mergedk/tokyo/tokyo.brd

## EAGLE design tokyo.brd (2019-07-08)

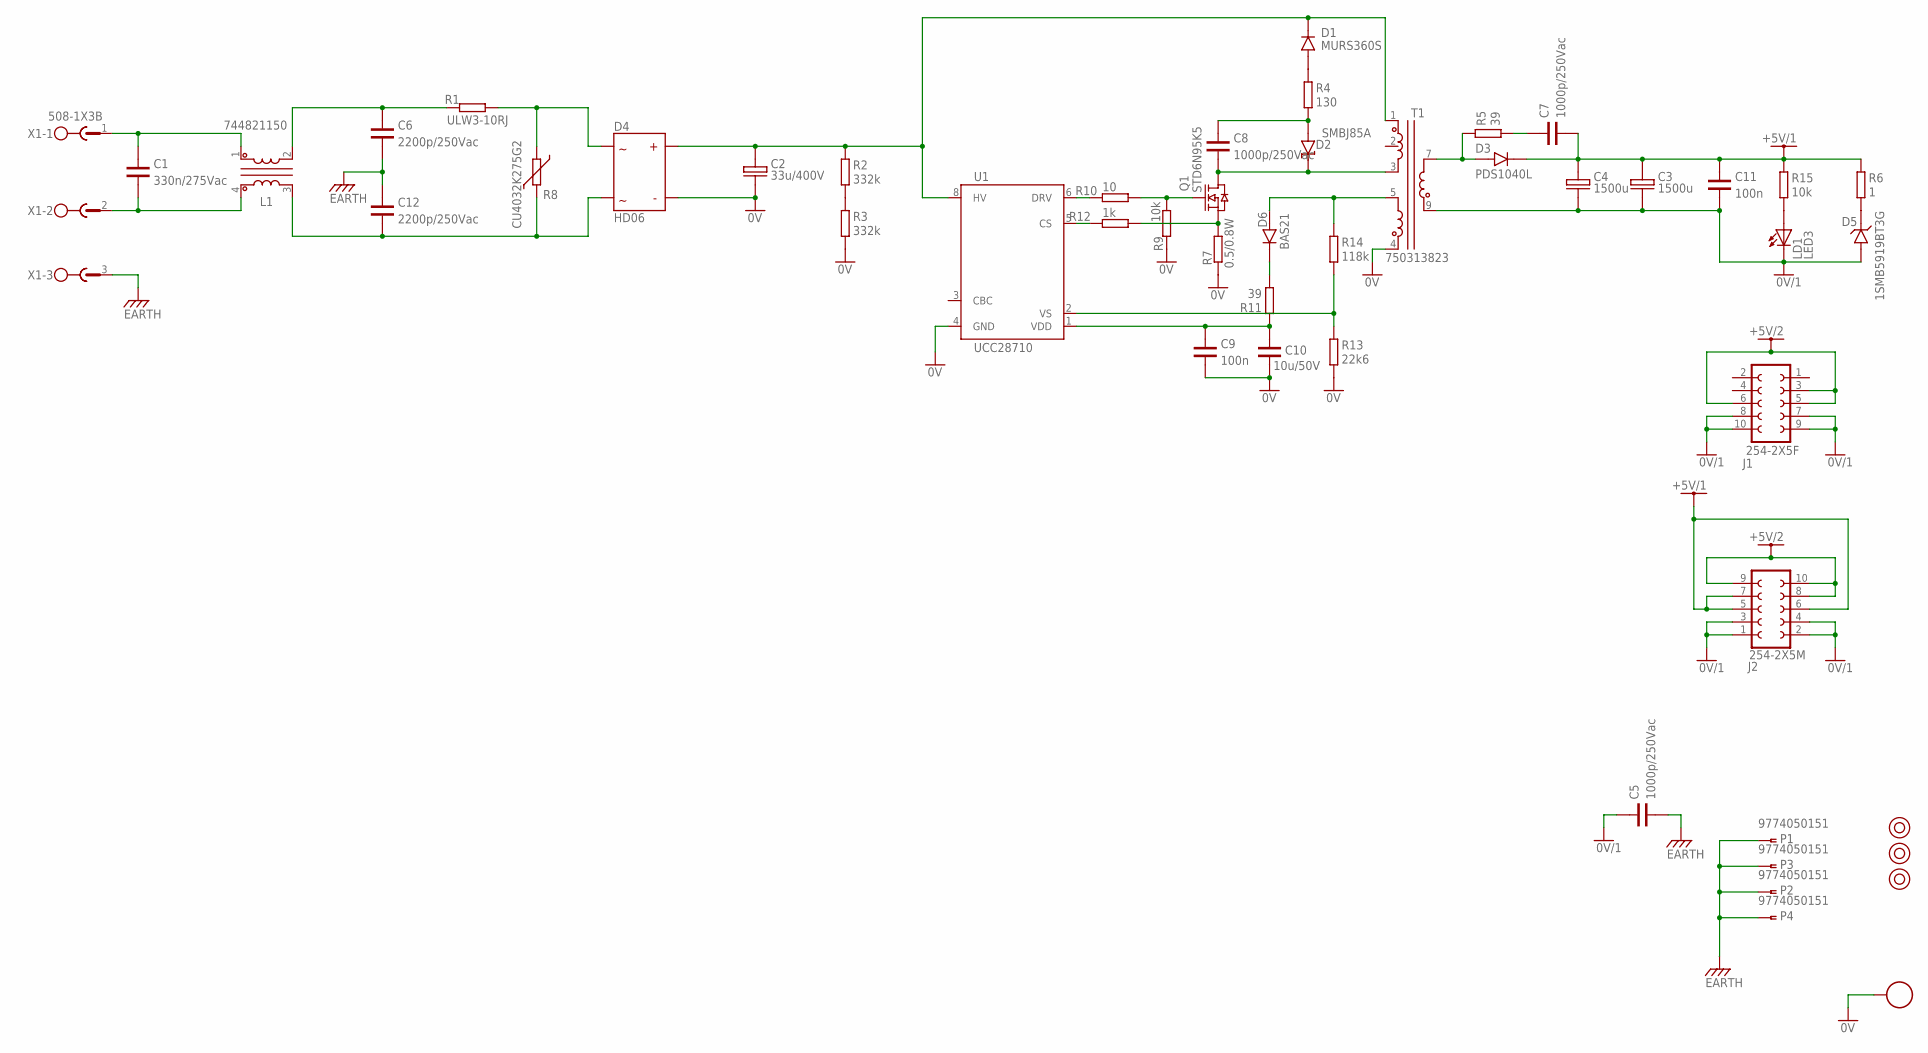
[picture p1: schematic tokyo.sch]

Parts:
0V: TESTPOINT
C1: 330n/275Vac; 15X8.5
C2: 33u/400V; D18
C3, C4: 1500u; D10
C5, C7, C8: 1000p/250Vac; 1812
C6, C12: 2200p/250Vac; 2211
C9, C11: 100n; 0603
C10: 10u/50V; 1206
D1: MURS360S; DO-214AA
D2: SMBJ85A; DO-214AA
D3: PDS1040L; POWERDI5
D4: HD06; MINIDIP
D5: 1SMB5919BT3G; DO-214AA
D6: BAS21; SOT23
FIDUCIAL1, FIDUCIAL2, FIDUCIAL3: FIDUCIAL
J1: 254-2X5F
J2: 254-2X5M
L1: 744821150
LD1: LED3
P1, P2, P3, P4: 9774050151
Q1: STD6N95K5; DPAK
R1: ULW3-10RJ; 15X6
R2, R3: 332k; 1206
R4: 130; 1206
R5: 39; 1206
R6: 1; 1206
R7: 0.5/0.8W; 2512
R8: CU4032K275G2; 4032
R9, R15: 10k; 0603
R10: 10; 0603
R11: 39; 0603
R12: 1k; 0603
R13: 22k6; 0603
R14: 118k; 0603
T1: 750313823; EE16
U1: UCC28710; SOIC7
X1: 508-1X3B

Connections:
0V: 0V.P$1, C2.2, C9.2, C10.2, D4.2, R3.2, R7.1, R9.1, R13.2, T1.4, U1.4 (GND)
0V/1: C3.2, C4.2, C5.1, C11.2, D5.2, J1.7, J1.8, J1.9, J1.10, J2.1, J2.2, J2.3, J2.4, LD1.C, T1.9
+5V/1: C3.1, C4.1, C7.2, C11.1, D3.3 (1), J2.5, J2.6, J2.7, R6.1, R15.1
+5V/2: J1.3, J1.5, J1.6, J2.8, J2.9, J2.10
EARTH: C5.2, C6.1 (2), C12.2 (1), P1.P1, P2.P1, P3.P1, P4.P1, X1.3
unnamed: C6.2 (1), L1.2, R1.1
unnamed: C12.1 (2), D4.4, L1.3, R8.2
unnamed: D6.1 (2), R14.1, T1.5
unnamed: D4.3, R1.P$2 (2), R8.1
unnamed: LD1.A, R15.2
unnamed: C7.1, R5.2
unnamed: R2.2, R3.1
unnamed: D3.1 (2), D3.2, R5.1, T1.7
unnamed: C2.1, D1.1, D4.1, R2.1, T1.1, U1.8 (HV)
unnamed: D1.2, R4.1
unnamed: C8.2, D2.1 (C), Q1.2 (D), T1.3
unnamed: Q1.3 (S), R7.2, R12.2
unnamed: R12.1, U1.5 (CS)
unnamed: Q1.1 (G), R9.2, R10.2
unnamed: C9.1, C10.1, R11.1, U1.1 (VDD)
unnamed: D5.1, R6.2
unnamed: C8.1, D2.2 (A), R4.2
unnamed: R13.1, R14.2, U1.2 (VS)
unnamed: C1.1, L1.1, X1.1
unnamed: C1.2, L1.4, X1.2
unnamed: R10.1, U1.6 (DRV)
unnamed: D6.3 (1), R11.2

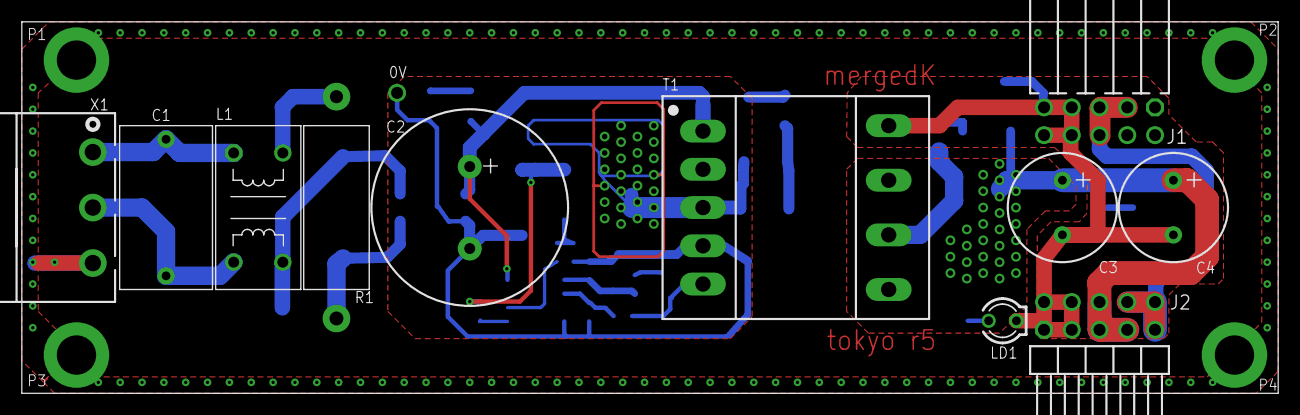
[picture p2: board tokyo.brd from above]

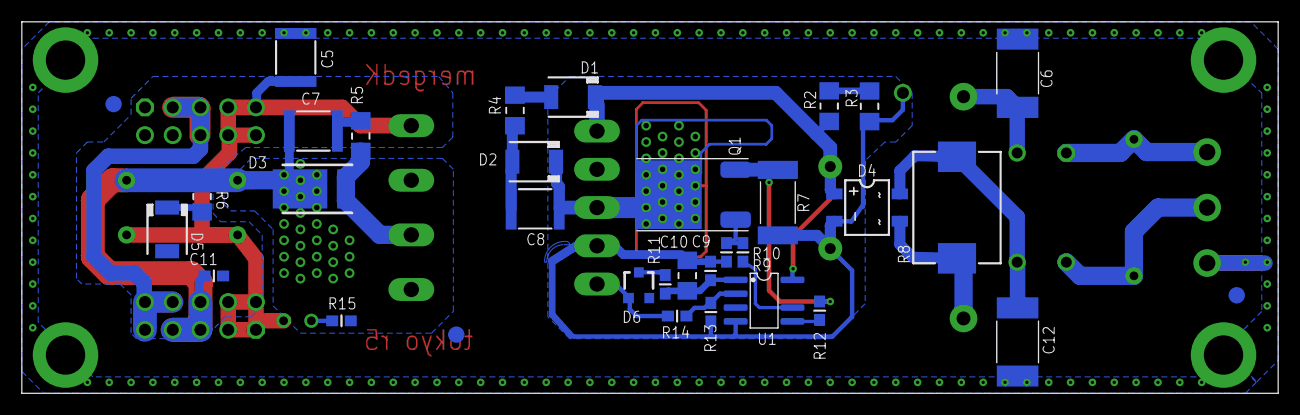
[picture p3: board tokyo.brd from below]

Board: 2 copper layers, 115.0 x 34.0 mm, 49 parts (33 on the bottom side), 27 nets.
