mergedk/tokyo/(commit log)

2015-01-27 Initial commit.
    [tokyo.brd, tokyo.sch]
2015-01-29 Ready for manufacture.
    [tokyo.brd, tokyo.sch]
2015-01-29 Updated libraries.
    [tokyo.brd, tokyo.sch]
2015-02-19 Removed relais, added choke, added dissipation area for output diode, added minimum load circuiRemoved relais, added choke, added dissipation area for output diode, added minimum load circuit.
    [tokyo.brd, tokyo.sch]
2015-03-02 Libraries updated.
    [tokyo.brd, tokyo.sch]
2015-03-02 New placement of mounting holes.
    [tokyo.brd]
2015-03-11 Revision for manufacturing.
    [tokyo.brd, tokyo.sch]
2015-03-12 Updated libraries, added CONTENTS to repository.
    [tokyo.sch]
2015-03-27 Renamed CONTENTS, added TODO. Changed BOM format fron numbers to CSV.
2015-03-27 Corrected value for C10.
    [tokyo.brd, tokyo.sch]
2015-06-14 Changed R3 to 330 (LD1 was too dim). Corrected BOM (LD1 should be a green LED).
    [tokyo.brd, tokyo.sch]
2015-10-15 Incorporated changes required for EMC tests: replaced transzorb with varistor, changed position of line choke.
    [tokyo.brd, tokyo.sch]
2015-10-19 Changed R15 to 10 k due to bright LED usage. Renumbered all components.
    [tokyo.brd, tokyo.sch]
2015-10-19 Removed tokyo.bom from revision control.
2015-10-20 Changed values of R13 and R14 in order to get +5.5V on output.
    [tokyo.brd, tokyo.sch]
2017-11-26 Updated TODO (problems with redundant power supply operation).
2019-07-08 Added .hgignore to repo.
    [tokyo.brd, tokyo.sch]
2019-07-08 Corrected +5V/2 routing.
    [tokyo.brd, tokyo.sch]
2019-08-25 Moved repo from mercurial to git.
    [tokyo.brd, tokyo.sch]
